Alectardy98/zmk-apple-desktop-bus-keyboard/Production_Files_JLCPCB/production_files/BOM-ADBv2.csv

Comment | Designator | Footprint | LCSC | Quantity
100nF | C12,C13,C14,C15,C16,C17,C18,C5,C8,C9 | C_0402_1005Metric | C1525 | 10
10k | R7 | R_0402_1005Metric | C25744 | 1
10uF | C10 | C_0402_1005Metric | C15525 | 1
12MHz | Y1 | Crystal_SMD_3225-4Pin_3.2x2.5mm | C9002 | 1
1k | R10,R11 | R_0402_1005Metric | C11702 | 2
1uF | C11,C4,C6,C7 | C_0402_1005Metric | C52923 | 4
22pF | C2,C3 | C_0402_1005Metric | C1555 | 2
27R | R8,R9 | R_0603_1608Metric | C25190 | 2
5.1k | R12,R6 | R_0402_1005Metric | C25905 | 2
500mA | F1 | Fuse_1206_3216Metric | C70076 | 1
Conn_01x04_MountingPin | J6 | JST_SH_SM04B-SRSS-TB_1x04-1MP_P1.00mm_Horizontal | C160404 | 1
EC11 | EC11_01 | CONN-SMD_SM05B-SRSS-TB-LF-SN | C19271999 | 1
RP2040 | U2 | RP2040-QFN-56 | C2040 | 1
SPI | SPI_01 | CONN-SMD_SM05B-SRSS-TB-LF-SN | C19271999 | 1
SRV05-4 | U3 | SOT-23-6-routable | C2836319 | 1
USB_C | J5 | USB_C_Receptacle_HRO_TYPE-C-31-M-12 | C165948 | 1
W25Q128JVS | U6 | SOIC-8_5.23x5.23mm_P1.27mm | C97521 | 1
XC6206 | U5 | SOT-23 | C5446 | 1
