Alectardy98/zmk-apple-desktop-bus-keyboard/assets/kicad_PCB_Source_Alectardy98/ADBv2.kicad_pcb

## KiCad design assets/kicad_PCB_Source_Alectardy98/ADBv2.kicad_pcb (2026-11-03)

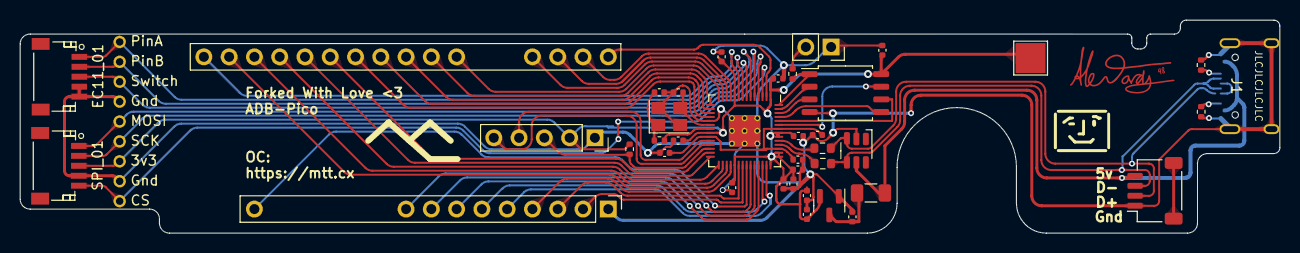
[picture p1: board ADBv2.kicad_pcb from above]

Board: 2 copper layers, 126.6 x 21.4 mm, 49 parts (1 on the bottom side), 54 nets.

Parts:
C2, C3: 22pF; C_0402_1005Metric
C4, C6, C7, C11: 1uF; C_0402_1005Metric
C5, C8, C9, C12, C13, C14, C15, C16, C17, C18: 100nF; C_0402_1005Metric
C10: 10uF; C_0402_1005Metric
EC11_01: EC11; CONN-SMD_SM05B-SRSS-TB-LF-SN
F1: 500mA; Fuse_1206_3216Metric
H1, H2, H3, H4, H5, H6, H7, H9, H10: Tht; Small THT
H8: Random Hole; Alectardy985
J2: TOP; PinHeader_1x20_P2.54mm_Vertical
J3: BOTTOM; PinHeader_1x20_P2.54mm_Vertical
J5: USB_C; USB_C_Receptacle_HRO_TYPE-C-31-M-12
J6: Conn_01x04_MountingPin; JST_SH_SM04B-SRSS-TB_1x04-1MP_P1.00mm_Horizontal
J20: SWD; PinSocket_1x05_P2.54mm_Vertical
R6, R12: 5.1k; R_0402_1005Metric
R7: 10k; R_0402_1005Metric
R8, R9: 27R; R_0603_1608Metric
R10, R11: 1k; R_0402_1005Metric
SPI_01: SPI; CONN-SMD_SM05B-SRSS-TB-LF-SN
SW2: Boot; PinSocket_1x02_P2.54mm_Vertical
U2: RP2040; RP2040-QFN-56
U3: SRV05-4; SOT-23-6-routable
U5: XC6206; SOT-23
U6: W25Q128JVS; SOIC-8_5.23x5.23mm_P1.27mm
V+1: 3v3Pad; TestPoint_Pad_3.0x3.0mm
Y1: 12MHz; Crystal_SMD_3225-4Pin_3.2x2.5mm

Connections:
+1V1: C7.1, C8.1, C9.1, U2.23 (DVDD), U2.45 (VREG_VOUT), U2.50 (DVDD)
+3V3: C5.1, C6.2, C10.1, C11.1, C12.1, C13.1, C14.1, C15.1, C16.1, C17.1, C18.1, H3.1 (Pin_1_1), J20.2, R7.1, SPI_01.3, U2.1 (IOVDD), U2.10 (IOVDD), U2.22 (IOVDD), U2.33 (IOVDD), U2.42 (IOVDD), U2.43 (ADC_AVDD), U2.44 (VREG_VIN), U2.48 (USB_VDD), U2.49 (IOVDD), U5.2 (VO), U6.8 (VCC), V+1.1 (Pin_1_1)
+5V: C4.2, F1.2, U5.3 (VI)
/CC1: J5.A5 (CC1), R6.1
/CC2: J5.B5 (CC2), R12.1
/D_+: R8.2, U2.47 (D+)
/D_-: R9.2, U2.46 (D-)
/XTAL_O: C3.2, R10.1, Y1.1
/~USB_BOOT: R11.1, SW2.2
C0: J3.2 (C0), U2.35 (GPIO23)
C1: J3.3 (C1), U2.34 (GPIO22)
C2: J3.4 (C2), U2.32 (GPIO21)
C3: J3.5 (C3), U2.41 (GPIO29/ADC3)
C4: J3.6 (C4), U2.40 (GPIO28/ADC2)
C5: J3.7 (C5), U2.39 (GPIO27/ADC1)
C6: J3.8 (C6), U2.38 (GPIO26/ADC0)
C7: J3.9 (C7), U2.37 (GPIO25)
CS: R11.2, U2.56 (QSPI_SS_N), U6.1 (~CS)
CS1: H1.1 (Pin_1_1), SPI_01.5, U2.3 (GPIO1)
CapsLock: J3.15 (CAPSLOCK), U2.36 (GPIO24)
Command: J2.4 (COMMAND), U2.13 (GPIO10)
Control: J2.16 (CONTROL), U2.31 (GPIO20)
DBUS+: J5.A6 (D+), J5.B6 (D+), J6.2, R8.1, U3.3 (IO2)
DBUS-: J5.A7 (D-), J5.B7 (D-), J6.3, R9.1, U3.4 (IO3)
EC11Pin1: EC11_01.1, H9.1 (Pin_1_1), U2.8 (GPIO6)
EC11Pin2: EC11_01.2, H7.1 (Pin_1_1), U2.7 (GPIO5)
EC11Pin3: EC11_01.3, H6.1 (Pin_1_1), U2.6 (GPIO4)
GND: C2.1, C3.1, C4.1, C5.2, C6.1, C7.2, C8.2, C9.2, C10.2, C11.2, C12.2, C13.2, C14.2, C15.2, C16.2, C17.2, C18.2, EC11_01.4, EC11_01.5, H2.1 (Pin_1_1), H10.1 (Pin_1_1), J3.1 (GROUND), J5.A1 (GND), J5.A12 (GND), J5.B1 (GND), J5.B12 (GND), J5.S1 (SHIELD), J6.1, J20.1, R6.2, R12.2, SPI_01.4, SW2.1, U2.19 (TESTEN), U2.57 (GND), U3.2 (VN), U5.1 (GND), U6.4 (GND), Y1.2, Y1.4
MOSI: H5.1 (Pin_1_1), SPI_01.1, U2.5 (GPIO3)
unnamed: C2.2, U2.20 (XTAL_IN), Y1.3
unnamed: R10.2, U2.21 (XTAL_OUT)
Option: J2.3 (OPTION), U2.12 (GPIO9)
Power: J2.15 (POWER), U2.30 (GPIO19)
QSPI_CLK: U2.52 (QSPI_SCLK), U6.6 (CLK)
R0: J2.11 (R0), U2.18 (GPIO15)
R1: J2.2 (R1), U2.11 (GPIO8)
R2: J2.1 (R2), U2.2 (GPIO0)
R3: J2.13 (R3), U2.28 (GPIO17)
R4: J2.7 (R4), U2.14 (GPIO11)
R5: J2.8 (R5), U2.15 (GPIO12)
R6: J2.9 (R6), U2.16 (GPIO13)
R7: J2.10 (R7), U2.17 (GPIO14)
R8: J2.12 (R8), U2.27 (GPIO16)
R9: J2.14 (R9), U2.29 (GPIO18)
SCK: H4.1 (Pin_1_1), SPI_01.2, U2.4 (GPIO2)
SD0: U2.53 (QSPI_SD0), U6.5 (DI(IO0))
SD1: U2.55 (QSPI_SD1), U6.2 (DO(IO1))
SD2: U2.54 (QSPI_SD2), U6.3 (IO2)
SD3: U2.51 (QSPI_SD3), U6.7 (IO3)
SWCLK: J20.4, U2.24 (SWCLK)
SWD: J20.5, U2.25 (SWDIO)
Shift: J2.17 (SHIFT), U2.9 (GPIO7)
VBUS: F1.1, J5.A4 (VBUS), J5.A9 (VBUS), J5.B4 (VBUS), J5.B9 (VBUS), J6.4, U3.5 (VP)
~RESET: J20.3, R7.2, U2.26 (~RUN)
